maycoaja/ECG-Monitoring-LoRaWAN/Sensor Calibration/Kalibrasi HR/Data ECG RAW/ecg_raw_125hz_ade1.csv

ecg_value
1919
1903
1949
1927
1959
1987
1968
2016
1998
2019
2055
2033
2084
2034
2041
2037
1990
2022
1981
1979
1970
1923
1943
1902
1899
1901
1856
1883
1850
1867
1872
1837
1877
1837
1855
1872
1841
1877
1857
1872
1887
1870
1902
1862
1886
1902
1859
1894
1859
1859
1874
1839
1878
1842
1855
1873
1843
1872
1844
1869
1897
1893
1949
1917
1978
1972
1925
1922
1872
1849
1841
1804
1833
1794
1808
1802
1775
1817
1794
1808
1749
1750
2197
3055
2992
1905
1499
1442
1469
1714
1782
1744
1790
1771
1802
1815
1796
1840
1806
1837
1854
1840
1887
1867
1904
1935
1927
1963
1936
1942
1939
1895
1924
1877
1872
1857
1812
1840
1781
1780
1778
1745
1773
1726
1737
1744
1721
1750
1717
1735
1745
1718
1774
1727
1765
1782
1736
1774
1741
1765
1765
1733
1769
1728
1743
1750
1723
1743
1699
1718
1729
1706
1735
1697
1711
1738
1721
1782
1748
1794
1829
1791
1791
1722
1699
1689
1655
1678
1635
1660
1659
1629
1663
1644
1661
1636
1535
1759
2384
3013
2272
1470
1405
1237
1361
1596
1615
1648
1616
1647
1654
1648
1682
1661
1699
1709
1686
1738
1728
1760
1777
1771
1825
1795
1823
1811
1775
1823
1780
1778
1773
1724
1753
1684
1686
1680
1646
1674
1631
1653
1655
1632
1680
1650
1674
1691
1670
1702
1675
1697
1696
1685
1721
1680
1723
1729
1691
1725
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
