maycoaja/ECG-Monitoring-LoRaWAN/Sensor Calibration/Kalibrasi HR/Data ECG RAW/ecg_raw_125hz_mayco1.csv

ecg_value
2095
2055
1988
1936
1851
1748
1690
1555
1508
1560
1535
1521
1553
1607
1571
1648
1687
1614
1723
1856
1853
1915
1942
1933
1927
1987
1971
2008
2074
2088
2078
2091
2030
2033
1983
1950
1940
1963
1950
1982
1936
1892
1909
1897
1950
1965
2082
2690
2977
2155
1667
1654
1535
1670
1846
1907
1787
1300
911
622
674
953
1294
1427
1620
1799
1919
2031
2085
2107
2135
2112
2061
2077
2064
2064
2025
1936
1842
1808
1739
1743
1798
1777
1747
1750
1711
1673
1681
1677
1698
1692
1712
1701
1645
1584
1584
1621
1595
1616
1691
1761
1818
1856
1855
1897
1931
1938
1973
2014
2031
2066
2128
2151
2204
2256
2270
2306
2256
2361
3090
3520
2551
2073
2025
1855
1946
2093
2160
2150
2139
2130
2118
2124
2135
2143
2154
2155
2171
2151
2153
2160
2157
2179
2208
2211
2217
2197
2174
2162
2116
2032
1997
1963
1933
1901
1894
1895
1905
1886
1899
1913
1845
1866
1899
1919
1857
1840
1841
1845
1840
1822
1827
1869
1887
1906
1948
1953
1921
1882
1859
1831
1805
1792
1780
1761
1756
1766
1775
1758
1762
1790
1691
1893
2686
2620
1868
1595
1430
1372
1535
1658
1710
1730
1740
1758
1760
1777
1787
1811
1827
1845
1872
1904
1917
1929
1963
1978
1991
1990
2000
2003
1987
1968
1936
1879
1833
1775
1758
1734
1721
1706
1685
1707
1716
1716
1707
1712
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
