maycoaja/ECG-Monitoring-LoRaWAN/Sensor Calibration/Kalibrasi HR/Data ECG RAW/ecg_raw_125hz_ade2 copy.csv

ecg_value
2027
2027
2027
2027
2027
2027
2027
2027
2027
2027
2027
2027
2027
2027
2027
2027
2027
2027
2027
2027
2027
2027
2027
2027
2027
2027
2027
2027
2027
2027
2027
2027
2027
2027
2027
2027
2027
2027
2027
2027
2027
2027
2027
2027
2027
2027
2027
2027
2027
2027
2027
2027
2027
2027
2027
2027
2027
2027
2027
2027
2027
2027
2027
2027
2027
2027
2027
2027
2027
2027
2027
2027
2027
2027
2027
2027
2027
2027
2027
2027
2027
2027
2027
2027
2027
2027
2027
2027
2027
2027
2027
2027
2027
2027
2027
2027
2027
2027
2027
2027
2027
2027
2027
2027
2027
2027
2027
2027
2027
2027
2027
2027
2027
2027
2027
2027
2027
2027
2027
2027
2027
2027
2027
2027
2027
2027
2027
2027
2027
2027
2027
2027
2027
2027
2027
2027
2027
2027
2027
2027
2027
2027
1627
1646
1624
1680
1691
1712
1738
1714
1751
1729
1734
1761
1738
1758
1755
1739
1766
1745
1826
1840
1850
1886
1838
1857
1843
1811
1828
1779
1794
1803
1813
1830
1780
1826
1802
1807
1866
1838
1898
1955
1965
1974
1872
1829
1744
1712
1705
1642
1678
1648
1642
1659
1622
1625
1453
1609
2359
3266
2635
1527
1168
1086
1264
1532
1535
1557
1595
1573
1639
1633
1651
1697
1677
1718
1703
1712
1731
1694
1725
1697
1724
1756
1749
1814
1809
1823
1817
1763
1805
1754
1746
1779
1743
1792
1770
1767
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
