maycoaja/ECG-Monitoring-LoRaWAN/Sensor Calibration/Kalibrasi HR/Data HR/plot_hr_scatter_all.png

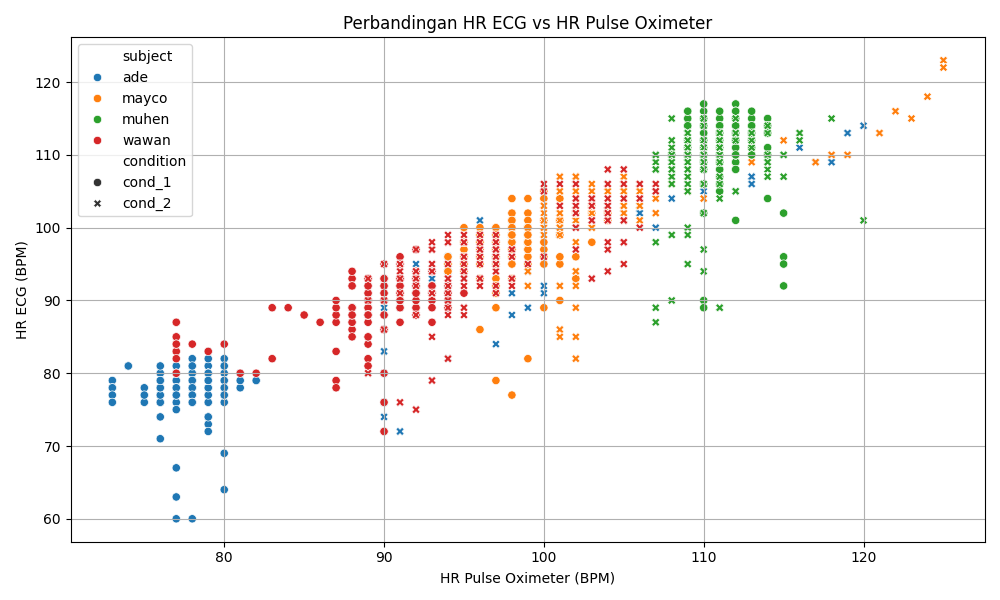
Sensor Calibration/Kalibrasi HR/Data HR/plot_hr_scatter_all.png
